JayChintala/Multirotor-Operated-Lab-Experiments-MOLE/README.md

# Multirotor-Operated-Lab-Experiments-MOLE-
Project for CMU's Electromechanical Systems Class. Aims to design a modular drone with hot swappable payloads.

This repo will contain most of the softwares, schematics for the project. 

## Companion computer (Raspberry Pi)

The Raspberry Pi companion computer setup (MAVLink routing to the flight controller, link check and bench motor test scripts) is in [`companion/`](companion/README.md).
