JayChintala/Multirotor-Operated-Lab-Experiments-MOLE/sim/README.md

# MOLE quad simulation: ArduPilot SITL + Gazebo Harmonic

Simulates the MOLE quadcopter with the **same firmware as the real flight controller**
(ArduCopter 4.7.2, `fb773567`) and the **real FC's flight parameters**, in Gazebo Harmonic
on ROS 2 Jazzy (Ubuntu 24.04).

```
Gazebo (mole_quad model, 1 kHz physics) ──JSON :9002──> ArduCopter SITL 4.7.2
                                                          ├─ tcp:5760  MAVROS (ROS 2 topics under /mavros)
                                                          └─ tcp:5762  QGroundControl, MAVProxy or scripts
```

## One-time setup (outside the repo)

SITL and the ArduPilot Gazebo plugin are built in `~/mole_sim` (the launch file's default paths):

```bash
mkdir -p ~/mole_sim && cd ~/mole_sim
# ArduCopter SITL at the exact release the real FC runs
git clone --recurse-submodules -b Copter-4.7.2 https://github.com/ArduPilot/ardupilot.git ardupilot-4.7.2
cd ardupilot-4.7.2 && Tools/environment_install/install-prereqs-ubuntu.sh -y   # once per machine
./waf configure --board sitl && ./waf copter
# ArduPilot plugin for Gazebo Harmonic
cd ~/mole_sim && git clone https://github.com/ArduPilot/ardupilot_gazebo
cd ardupilot_gazebo && mkdir -p build && cd build
source /opt/ros/jazzy/setup.bash && cmake .. -DCMAKE_BUILD_TYPE=RelWithDebInfo && make -j8
```

Also needed: `sudo apt install ros-jazzy-ros-gz ros-jazzy-mavros ros-jazzy-mavros-extras` and
MAVROS's GeographicLib datasets. (On the first machine these steps were done by hand; the
commands above are the equivalent from scratch and have not been re-run on a clean install.)

## Build and run

```bash
cd sim/ros2_ws
source /opt/ros/jazzy/setup.bash
colcon build --symlink-install
source install/setup.bash

ros2 launch mole_gazebo sitl.launch.py                    # Gazebo window, simulated GPS, MAVROS
ros2 launch mole_gazebo sitl.launch.py gps:=false         # like the real drone today: no GPS/compass
ros2 launch mole_gazebo sitl.launch.py headless:=true     # no window (CI, SSH)
```

| Argument | Default | Meaning |
|---|---|---|
| `gps` | `true` | `true`: simulated GPS + compass (Loiter/Guided/Auto/RTL work). `false`: matches the real drone, only Stabilize/AltHold/Acro |
| `mavros` | `true` | start MAVROS on `tcp:5760` |
| `headless` | `false` | Gazebo server only |
| `wipe` | `true` | start SITL from the parameter files every time (no stale eeprom) |
| `ardupilot_dir` | `~/mole_sim/ardupilot-4.7.2` | ArduPilot build with `build/sitl/bin/arducopter` |
| `ardupilot_gazebo_dir` | `~/mole_sim/ardupilot_gazebo` | plugin build with `build/libArduPilotPlugin.so` |

SITL logs (`.BIN`, same format as the real FC's) go to `~/mole_sim/runs/<date_time>/logs/`.
Close the Gazebo window or press Ctrl+C to stop everything.

Launching from **VS Code's terminal** works: the launch file removes the snap environment
variables that otherwise crash Gazebo's window.

Connect **QGroundControl** with a TCP link to `127.0.0.1:5762`, or MAVProxy with
`mavproxy.py --master=tcp:127.0.0.1:5762`.

## Check it works

```bash
PY=~/mole_sim/venv-ardupilot/bin/python      # any Python with pymavlink + Gazebo bindings
$PY src/mole_gazebo/scripts/smoke_test.py --rate-gain-scale 0.5
```

1. Motor test A–D: each spins the correct propeller in the correct direction.
2. AltHold take-off, roll/pitch steady in hover, altitude hold at mid-stick, hover throttle vs
   the real drone's 0.35.
3. Yaw right turns right. 4. Land and auto-disarm.

Results on 2026-11-08 (motor capped at the measured 2.0 kgf): **11/11 with
`--rate-gain-scale 0.5`** (roll/pitch rate 0.3 °/s RMS, altitude held within 3 cm, hover output
0.353). **With the real FC's gains the roll/pitch steadiness check fails** (62 °/s RMS). See below.
The no-GPS configuration (`gps:=false mavros:=false`) also passed every check with halved gains.

## Finding: the real FC's roll/pitch tune oscillates in simulation

With the real FC's rate gains (`ATC_RAT_RLL/PIT_P` 0.135, `_I` 0.135, `_D` 0.0036: the
ArduPilot defaults) the simulated drone's roll rate loop oscillates in hover (roll rate 62 °/s
RMS, pitch 15 °/s); with the gains halved it hovers steadily (0.3 °/s).

| Motor model | Real gains | Gains × 0.5 |
|---|---|---|
| **Capped at measured 2.0 kgf, lag 0.02 s (current)** | roll 62 °/s RMS; holds altitude | steady |
| Uncapped (extrapolated 3.8 kgf), lag 0.01 s | oscillates, climbs 18 m in 8 s | holds altitude; fast roll wobble (±3°, ≥10 Hz) |
| Uncapped, lag 0.02 s | oscillates, climbs 9.5 m | steady |
| Uncapped, lag 0.04 s | oscillates, climbs 15 m | steady |

The roll/pitch oscillation with the real gains appears in every variant. Flight log 00016 (the
cage-ceiling crash) shows motor outputs swinging between minimum (1150) and near maximum (1949)
while `CTUN.ThO` was 0 and the drone climbed ~9 m. The uncapped model reproduced that climb, but
it overstated thrust above 73 % throttle; with the motor capped at the measured 2.0 kgf the
simulated oscillation is milder and the drone does not climb. So the simulator supports
"the default roll/pitch gains are too high for this airframe" but does **not** currently
reproduce the climb. The fast wobble with 0.01 s lag is probably an artifact of the simulated
rotor speed loop (natural frequency ~10 Hz at that setting); settling it needs real motor
step-response data. **Simulation results are not a substitute for careful
real-world tuning**: use them to choose a safer starting point, then tune on the real drone
(start low, e.g. halved rate gains, tethered or at low height).

## How the model was built

All numbers are in [`config/vehicle.json`](ros2_ws/src/mole_gazebo/config/vehicle.json);
[`scripts/gen_model.py`](ros2_ws/src/mole_gazebo/scripts/gen_model.py) generates
`models/mole_quad/model.sdf` from it. Edit the JSON and re-run the script; don't edit the SDF.

| Quantity | Value | Source |
|---|---|---|
| Frame + arms + motors + Pi/FC/ESC/wiring | 0.700 kg | EMSD CAD mass properties |
| Battery (6S 12000 mAh), on top, 195 × 77 × 50 mm | 1.500 kg | team; re-measure (1.58 kg also quoted) |
| Props, 8 in | 4 × 13 g | team |
| **Total** | **2.252 kg**, CoG 37 mm above frame centre | |
| Inertia Ixx / Iyy / Izz | 0.0165 / 0.0150 / 0.0275 kg·m² | CAD + battery box + props |
| Motor layout | 280 mm front–back × 368 mm side–side | EMSD CAD; front = CAD −y (team) |
| Thrust, torque | T = 6.983e-6 ω², Q = 1.019e-7 ω² | `ROS/EMSD/motor_data.xlsx`, R² = 0.999 |
| Motor speed vs output | ω = 2214 (cmd + 0.048) rad/s | DC-motor fit of the same data, ±3 % thrust from hover to full |
| Maximum per motor | 2.0 kgf (19.7 N), ~16,000 rpm, 34.5 A | bench top point (DShot 1500, ~73 % output); team: ~2 kg at ~35 A is the real limit. Modelled as a motor torque cap (0.289 N·m), so outputs above ~0.73 add no thrust |
| Thrust/weight | 3.6 | 4 × 2.0 kgf / 2.25 kg |
| Hover | ~8,500 rpm, output 0.354 | matches real `MOT_THST_HOVER` 0.35 |
| Motor lag | 0.02 s | **assumed** |
| Spin, output channels | FR/RL CCW, FL/RR CW; SERVO1..4 = motors 4,1,2,3 | `companion/README.md`; FC log 00016 |

Propellers are spinning joints with Gazebo `LiftDrag` blades (as in ArduPilot's Iris model),
sized so thrust and reaction torque follow the measured curves.

## Parameters

| File | Contents |
|---|---|
| `config/mole_quad.parm` | 337 flight parameters from the real FC (tuning, filters, mixing, failsafes, EKF). **Generated**: re-run after retuning |
| `config/sitl_overrides.parm` | sim-only: level IMU (real FC is mounted roll-180), no output when disarmed, file logging, 6S battery |
| `config/sitl_gps.parm`, `sitl_nogps.parm` | the `gps:=` variants |

Load order: ArduPilot's stock `copter.parm` → `mole_quad.parm` → `sitl_overrides.parm` → GPS variant.

After a real flight with new parameters, refresh the sim from its log:

```bash
$PY src/mole_gazebo/scripts/extract_params.py path/to/new_log.bin src/mole_gazebo/config/mole_quad.parm
```

## Known limitations

- Motor lag is assumed (0.02 s); battery sag, ESC behaviour, prop wash, ground effect and
  vibration are not modelled. Body aerodynamic drag is not modelled.
- Motor speed is linear in output (ArduPilotPlugin limitation); thrust error ≤ 3 % over 0.15–0.95,
  larger near zero.
- Above ~73 % output the real motor is assumed current-limited at 2.0 kgf (torque cap); how
  the real ESC behaves there (current limiting vs more thrust at higher current) is not measured.
- Inertia comes from CAD with assumed component placement.
- The world is an open field; an indoor cage world needs the cage's dimensions.

## Notes for the hardware docs

`companion/README.md` says `SERVO1_FUNCTION`–`SERVO4_FUNCTION` are 33–36 (outputs 1–4 =
motors 1–4) and that `SERVO_BLH_RVMASK` = 9 reverses "motors 1 and 4". Log 00016 has
`SERVO1..4_FUNCTION` = 36, 33, 34, 35, so outputs 1 and 4 are motors **4 and 3**. The spin
directions were verified per motor, so the drone is fine; the README text is out of date.
