JayChintala/Multirotor-Operated-Lab-Experiments-MOLE/Misc/Sim1.png

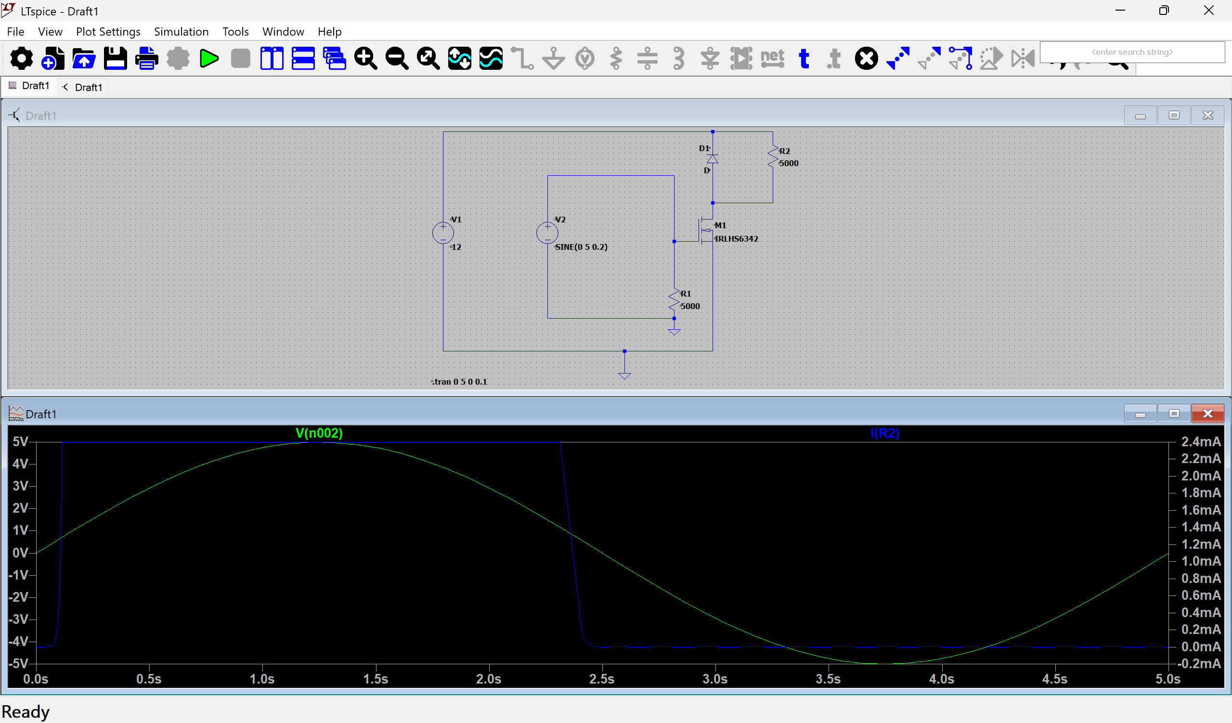
Misc/Sim1.png
