JayChintala/Multirotor-Operated-Lab-Experiments-MOLE/report/images/drone_clipart.png

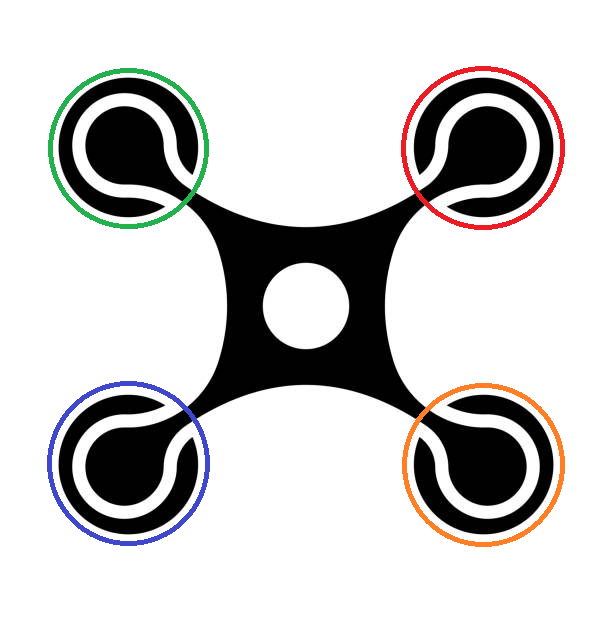
report/images/drone_clipart.png
