JayChintala/Multirotor-Operated-Lab-Experiments-MOLE/ROS/EMSD/cad/QAV-RXL2_8inch.step

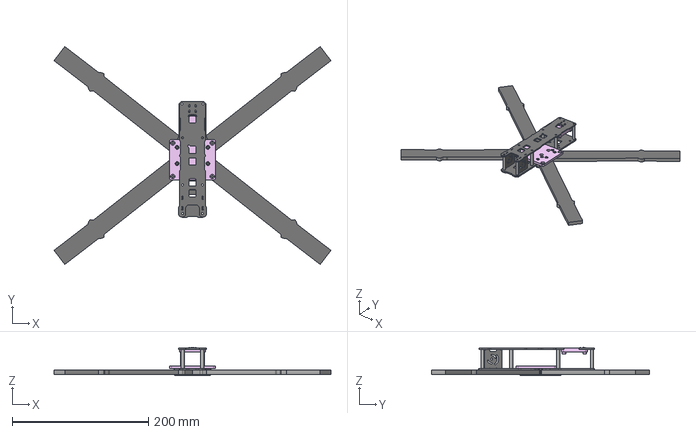
[picture p4: CAD file, 2026-11-09]
ROS/EMSD/cad/QAV-RXL2_8inch.step
406.3 x 319.7 x 41.5 mm
