JayChintala/Multirotor-Operated-Lab-Experiments-MOLE/ROS/EMSD/ros2_ws/src/emsd_drone_description/meshes/ground_pond.stl

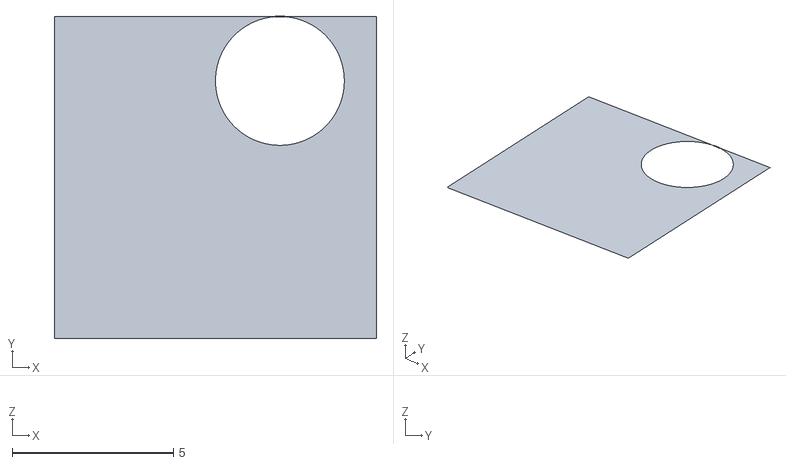
[picture p5: CAD file, 2026-11-09]
ROS/EMSD/ros2_ws/src/emsd_drone_description/meshes/ground_pond.stl
10.0 x 10.0 x 0
