JayChintala/Multirotor-Operated-Lab-Experiments-MOLE/ROS/EMSD/ros2_ws/src/emsd_drone_description/meshes/pond_bowl.stl

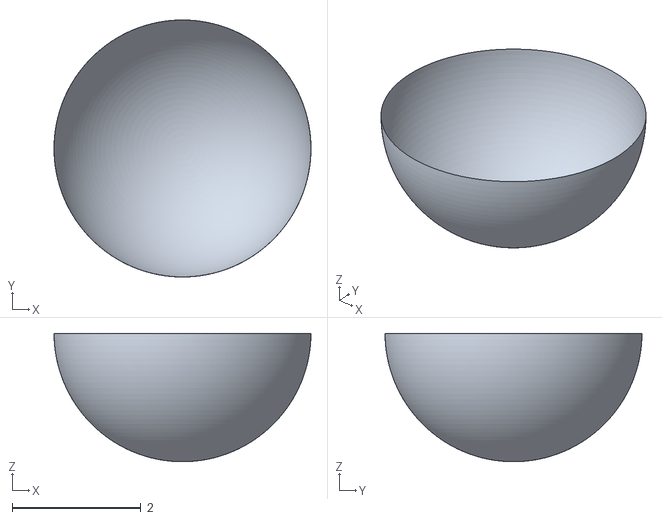
[picture p6: CAD file, 2026-11-09]
ROS/EMSD/ros2_ws/src/emsd_drone_description/meshes/pond_bowl.stl
4.00 x 4.00 x 2.00
