JayChintala/Multirotor-Operated-Lab-Experiments-MOLE/ROS/EMSD/ros2_ws/src/emsd_drone_description/meshes/frame.stl

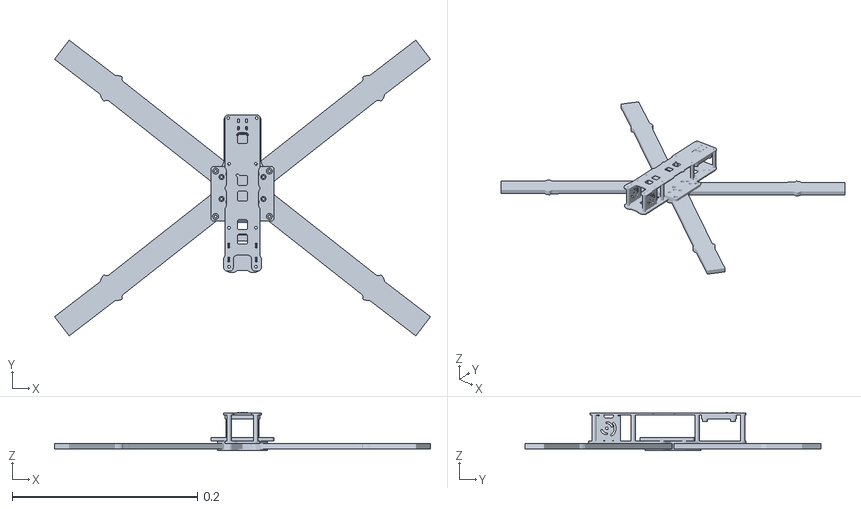
[picture p7: CAD file, 2026-11-09]
ROS/EMSD/ros2_ws/src/emsd_drone_description/meshes/frame.stl
0.406 x 0.32 x 0.0415
