JayChintala/Multirotor-Operated-Lab-Experiments-MOLE/sim/ros2_ws/src/mole_gazebo/models/mole_quad/model.sdf

<?xml version="1.0"?>
<!-- GENERATED by scripts/gen_model.py from config/vehicle.json. Do not edit by hand. -->
<!-- Total 2.252 kg; CoG [-0.0, 0.0, 37.2] mm; inertia diag [0.01647, 0.01495, 0.02751] kg m^2 -->
<sdf version="1.9">
  <model name="mole_quad">
    <link name="base_link">
      <inertial>
        <pose>-0.000008 0.000000 0.037503 0 0 0</pose>
        <mass>2.2000</mass>
        <inertia>
          <ixx>0.0147026</ixx>
          <ixy>1.2393e-09</ixy>
          <ixz>5.22634e-06</ixz>
          <iyy>0.0137637</iyy>
          <iyz>1.99803e-09</iyz>
          <izz>0.024573</izz>
        </inertia>
      </inertial>
      <collision name="frame_collision">
        <pose>0 0 0.0102 0 0 0</pose>
        <geometry><box><size>0.3197 0.4063 0.0415</size></box></geometry>
      </collision>
      <collision name="battery_collision">
        <pose>0.0 0.0 0.0560 0 0 0</pose>
        <geometry><box><size>0.195 0.077 0.05</size></box></geometry>
      </collision>
      <visual name="frame">
        <pose>0 0 0 0 0 1.570796</pose>
        <geometry><mesh><uri>model://mole_quad/meshes/frame.stl</uri></mesh></geometry>
        <material><ambient>0.24 0.3 0.38 1.0</ambient><diffuse>0.24 0.3 0.38 1.0</diffuse><specular>0.2 0.2 0.2 1</specular></material>
      </visual>
      <visual name="battery">
        <pose>0.0 0.0 0.0560 0 0 0</pose>
        <geometry><box><size>0.195 0.077 0.05</size></box></geometry>
        <material><ambient>0.85 0.75 0.1 1.0</ambient><diffuse>0.85 0.75 0.1 1.0</diffuse><specular>0.2 0.2 0.2 1</specular></material>
      </visual>
      <visual name="front_marker">
        <pose>0.1699 0 0.0310 0 0 0</pose>
        <geometry><sphere><radius>0.012</radius></sphere></geometry>
        <material><ambient>0.9 0.1 0.1 1.0</ambient><diffuse>0.9 0.1 0.1 1.0</diffuse><specular>0.2 0.2 0.2 1</specular></material>
      </visual>
      <visual name="motor_front_right">
        <pose>0.14 -0.184 0.0075 0 0 0</pose>
        <geometry><cylinder><radius>0.014</radius><length>0.020</length></cylinder></geometry>
        <material><ambient>0.08 0.08 0.08 1.0</ambient><diffuse>0.08 0.08 0.08 1.0</diffuse><specular>0.2 0.2 0.2 1</specular></material>
      </visual>
      <visual name="motor_rear_left">
        <pose>-0.14 0.184 0.0075 0 0 0</pose>
        <geometry><cylinder><radius>0.014</radius><length>0.020</length></cylinder></geometry>
        <material><ambient>0.08 0.08 0.08 1.0</ambient><diffuse>0.08 0.08 0.08 1.0</diffuse><specular>0.2 0.2 0.2 1</specular></material>
      </visual>
      <visual name="motor_front_left">
        <pose>0.14 0.184 0.0075 0 0 0</pose>
        <geometry><cylinder><radius>0.014</radius><length>0.020</length></cylinder></geometry>
        <material><ambient>0.08 0.08 0.08 1.0</ambient><diffuse>0.08 0.08 0.08 1.0</diffuse><specular>0.2 0.2 0.2 1</specular></material>
      </visual>
      <visual name="motor_rear_right">
        <pose>-0.14 -0.184 0.0075 0 0 0</pose>
        <geometry><cylinder><radius>0.014</radius><length>0.020</length></cylinder></geometry>
        <material><ambient>0.08 0.08 0.08 1.0</ambient><diffuse>0.08 0.08 0.08 1.0</diffuse><specular>0.2 0.2 0.2 1</specular></material>
      </visual>
      <sensor name="imu_sensor" type="imu">
        <pose degrees="true">0 0 0 180 0 0</pose>
        <always_on>1</always_on>
        <update_rate>1000</update_rate>
      </sensor>
    </link>

    <link name="rotor_front_right">
      <pose>0.14 -0.184 0.0225 0 0 0</pose>
      <inertial>
        <mass>0.013</mass>
        <inertia>
          <ixx>1e-07</ixx>
          <ixy>0</ixy>
          <ixz>0</ixz>
          <iyy>4e-05</iyy>
          <iyz>0</iyz>
          <izz>4e-05</izz>
        </inertia>
      </inertial>
      <visual name="blades">
        <geometry><box><size>0.2032 0.018 0.003</size></box></geometry>
        <material><ambient>0.15 0.4 0.95 1.0</ambient><diffuse>0.15 0.4 0.95 1.0</diffuse><specular>0.2 0.2 0.2 1</specular></material>
      </visual>
      <visual name="disc">
        <geometry><cylinder><radius>0.1016</radius><length>0.001</length></cylinder></geometry>
        <transparency>0.75</transparency>
        <material><ambient>0.15 0.4 0.95 0.25</ambient><diffuse>0.15 0.4 0.95 0.25</diffuse><specular>0.2 0.2 0.2 1</specular></material>
      </visual>
    </link>
    <joint name="rotor_front_right_joint" type="revolute">
      <parent>base_link</parent>
      <child>rotor_front_right</child>
      <axis>
        <xyz>0 0 1</xyz>
        <limit><lower>-1e16</lower><upper>1e16</upper></limit>
        <dynamics><damping>1e-6</damping></dynamics>
      </axis>
    </joint>
    <link name="rotor_rear_left">
      <pose>-0.14 0.184 0.0225 0 0 0</pose>
      <inertial>
        <mass>0.013</mass>
        <inertia>
          <ixx>1e-07</ixx>
          <ixy>0</ixy>
          <ixz>0</ixz>
          <iyy>4e-05</iyy>
          <iyz>0</iyz>
          <izz>4e-05</izz>
        </inertia>
      </inertial>
      <visual name="blades">
        <geometry><box><size>0.2032 0.018 0.003</size></box></geometry>
        <material><ambient>0.15 0.4 0.95 1.0</ambient><diffuse>0.15 0.4 0.95 1.0</diffuse><specular>0.2 0.2 0.2 1</specular></material>
      </visual>
      <visual name="disc">
        <geometry><cylinder><radius>0.1016</radius><length>0.001</length></cylinder></geometry>
        <transparency>0.75</transparency>
        <material><ambient>0.15 0.4 0.95 0.25</ambient><diffuse>0.15 0.4 0.95 0.25</diffuse><specular>0.2 0.2 0.2 1</specular></material>
      </visual>
    </link>
    <joint name="rotor_rear_left_joint" type="revolute">
      <parent>base_link</parent>
      <child>rotor_rear_left</child>
      <axis>
        <xyz>0 0 1</xyz>
        <limit><lower>-1e16</lower><upper>1e16</upper></limit>
        <dynamics><damping>1e-6</damping></dynamics>
      </axis>
    </joint>
    <link name="rotor_front_left">
      <pose>0.14 0.184 0.0225 0 0 0</pose>
      <inertial>
        <mass>0.013</mass>
        <inertia>
          <ixx>1e-07</ixx>
          <ixy>0</ixy>
          <ixz>0</ixz>
          <iyy>4e-05</iyy>
          <iyz>0</iyz>
          <izz>4e-05</izz>
        </inertia>
      </inertial>
      <visual name="blades">
        <geometry><box><size>0.2032 0.018 0.003</size></box></geometry>
        <material><ambient>1.0 0.5 0.1 1.0</ambient><diffuse>1.0 0.5 0.1 1.0</diffuse><specular>0.2 0.2 0.2 1</specular></material>
      </visual>
      <visual name="disc">
        <geometry><cylinder><radius>0.1016</radius><length>0.001</length></cylinder></geometry>
        <transparency>0.75</transparency>
        <material><ambient>1.0 0.5 0.1 0.25</ambient><diffuse>1.0 0.5 0.1 0.25</diffuse><specular>0.2 0.2 0.2 1</specular></material>
      </visual>
    </link>
    <joint name="rotor_front_left_joint" type="revolute">
      <parent>base_link</parent>
      <child>rotor_front_left</child>
      <axis>
        <xyz>0 0 1</xyz>
        <limit><lower>-1e16</lower><upper>1e16</upper></limit>
        <dynamics><damping>1e-6</damping></dynamics>
      </axis>
    </joint>
    <link name="rotor_rear_right">
      <pose>-0.14 -0.184 0.0225 0 0 0</pose>
      <inertial>
        <mass>0.013</mass>
        <inertia>
          <ixx>1e-07</ixx>
          <ixy>0</ixy>
          <ixz>0</ixz>
          <iyy>4e-05</iyy>
          <iyz>0</iyz>
          <izz>4e-05</izz>
        </inertia>
      </inertial>
      <visual name="blades">
        <geometry><box><size>0.2032 0.018 0.003</size></box></geometry>
        <material><ambient>1.0 0.5 0.1 1.0</ambient><diffuse>1.0 0.5 0.1 1.0</diffuse><specular>0.2 0.2 0.2 1</specular></material>
      </visual>
      <visual name="disc">
        <geometry><cylinder><radius>0.1016</radius><length>0.001</length></cylinder></geometry>
        <transparency>0.75</transparency>
        <material><ambient>1.0 0.5 0.1 0.25</ambient><diffuse>1.0 0.5 0.1 0.25</diffuse><specular>0.2 0.2 0.2 1</specular></material>
      </visual>
    </link>
    <joint name="rotor_rear_right_joint" type="revolute">
      <parent>base_link</parent>
      <child>rotor_rear_right</child>
      <axis>
        <xyz>0 0 1</xyz>
        <limit><lower>-1e16</lower><upper>1e16</upper></limit>
        <dynamics><damping>1e-6</damping></dynamics>
      </axis>
    </joint>

    <plugin filename="gz-sim-lift-drag-system" name="gz::sim::systems::LiftDrag">
      <link_name>rotor_front_right</link_name>
      <cp>0.07112 0 0</cp>
      <forward>0 1 0</forward>
      <upward>0 0 1</upward>
      <a0>0.3</a0>
      <cla>4.25</cla>
      <cda>0.87203</cda>
      <cma>0</cma>
      <alpha_stall>1.4</alpha_stall>
      <cla_stall>-0.025</cla_stall>
      <cda_stall>0</cda_stall>
      <cma_stall>0</cma_stall>
      <area>0.000899261</area>
      <air_density>1.2041</air_density>
    </plugin>
    <plugin filename="gz-sim-lift-drag-system" name="gz::sim::systems::LiftDrag">
      <link_name>rotor_front_right</link_name>
      <cp>-0.07112 0 0</cp>
      <forward>0 -1 0</forward>
      <upward>0 0 1</upward>
      <a0>0.3</a0>
      <cla>4.25</cla>
      <cda>0.87203</cda>
      <cma>0</cma>
      <alpha_stall>1.4</alpha_stall>
      <cla_stall>-0.025</cla_stall>
      <cda_stall>0</cda_stall>
      <cma_stall>0</cma_stall>
      <area>0.000899261</area>
      <air_density>1.2041</air_density>
    </plugin>
    <plugin filename="gz-sim-lift-drag-system" name="gz::sim::systems::LiftDrag">
      <link_name>rotor_rear_left</link_name>
      <cp>0.07112 0 0</cp>
      <forward>0 1 0</forward>
      <upward>0 0 1</upward>
      <a0>0.3</a0>
      <cla>4.25</cla>
      <cda>0.87203</cda>
      <cma>0</cma>
      <alpha_stall>1.4</alpha_stall>
      <cla_stall>-0.025</cla_stall>
      <cda_stall>0</cda_stall>
      <cma_stall>0</cma_stall>
      <area>0.000899261</area>
      <air_density>1.2041</air_density>
    </plugin>
    <plugin filename="gz-sim-lift-drag-system" name="gz::sim::systems::LiftDrag">
      <link_name>rotor_rear_left</link_name>
      <cp>-0.07112 0 0</cp>
      <forward>0 -1 0</forward>
      <upward>0 0 1</upward>
      <a0>0.3</a0>
      <cla>4.25</cla>
      <cda>0.87203</cda>
      <cma>0</cma>
      <alpha_stall>1.4</alpha_stall>
      <cla_stall>-0.025</cla_stall>
      <cda_stall>0</cda_stall>
      <cma_stall>0</cma_stall>
      <area>0.000899261</area>
      <air_density>1.2041</air_density>
    </plugin>
    <plugin filename="gz-sim-lift-drag-system" name="gz::sim::systems::LiftDrag">
      <link_name>rotor_front_left</link_name>
      <cp>0.07112 0 0</cp>
      <forward>0 -1 0</forward>
      <upward>0 0 1</upward>
      <a0>0.3</a0>
      <cla>4.25</cla>
      <cda>0.87203</cda>
      <cma>0</cma>
      <alpha_stall>1.4</alpha_stall>
      <cla_stall>-0.025</cla_stall>
      <cda_stall>0</cda_stall>
      <cma_stall>0</cma_stall>
      <area>0.000899261</area>
      <air_density>1.2041</air_density>
    </plugin>
    <plugin filename="gz-sim-lift-drag-system" name="gz::sim::systems::LiftDrag">
      <link_name>rotor_front_left</link_name>
      <cp>-0.07112 0 0</cp>
      <forward>0 1 0</forward>
      <upward>0 0 1</upward>
      <a0>0.3</a0>
      <cla>4.25</cla>
      <cda>0.87203</cda>
      <cma>0</cma>
      <alpha_stall>1.4</alpha_stall>
      <cla_stall>-0.025</cla_stall>
      <cda_stall>0</cda_stall>
      <cma_stall>0</cma_stall>
      <area>0.000899261</area>
      <air_density>1.2041</air_density>
    </plugin>
    <plugin filename="gz-sim-lift-drag-system" name="gz::sim::systems::LiftDrag">
      <link_name>rotor_rear_right</link_name>
      <cp>0.07112 0 0</cp>
      <forward>0 -1 0</forward>
      <upward>0 0 1</upward>
      <a0>0.3</a0>
      <cla>4.25</cla>
      <cda>0.87203</cda>
      <cma>0</cma>
      <alpha_stall>1.4</alpha_stall>
      <cla_stall>-0.025</cla_stall>
      <cda_stall>0</cda_stall>
      <cma_stall>0</cma_stall>
      <area>0.000899261</area>
      <air_density>1.2041</air_density>
    </plugin>
    <plugin filename="gz-sim-lift-drag-system" name="gz::sim::systems::LiftDrag">
      <link_name>rotor_rear_right</link_name>
      <cp>-0.07112 0 0</cp>
      <forward>0 1 0</forward>
      <upward>0 0 1</upward>
      <a0>0.3</a0>
      <cla>4.25</cla>
      <cda>0.87203</cda>
      <cma>0</cma>
      <alpha_stall>1.4</alpha_stall>
      <cla_stall>-0.025</cla_stall>
      <cda_stall>0</cda_stall>
      <cma_stall>0</cma_stall>
      <area>0.000899261</area>
      <air_density>1.2041</air_density>
    </plugin>

    <plugin filename="gz-sim-joint-state-publisher-system" name="gz::sim::systems::JointStatePublisher"/>

    <plugin name="ArduPilotPlugin" filename="ArduPilotPlugin">
      <fdm_addr>127.0.0.1</fdm_addr>
      <fdm_port_in>9002</fdm_port_in>
      <connectionTimeoutMaxCount>5</connectionTimeoutMaxCount>
      <lock_step>1</lock_step>
      <have_32_channels>0</have_32_channels>
      <modelXYZToAirplaneXForwardZDown degrees="true">0 0 0 180 0 0</modelXYZToAirplaneXForwardZDown>
      <gazeboXYZToNED degrees="true">0 0 0 180 0 90</gazeboXYZToNED>
      <imuName>base_link::imu_sensor</imuName>

      <!-- SERVO2 = ArduPilot motor 1 (front-right, CCW) -->
      <control channel="1">
        <jointName>rotor_front_right_joint</jointName>
        <useForce>1</useForce>
        <type>VELOCITY</type>
        <multiplier>2213.8</multiplier>
        <offset>0.0481</offset>
        <servo_min>1000</servo_min>
        <servo_max>2000</servo_max>
        <p_gain>0.002</p_gain>
        <i_gain>0.0390625</i_gain>
        <d_gain>0</d_gain>
        <i_max>0.289</i_max>
        <i_min>-0.289</i_min>
        <cmd_max>0.289</cmd_max>
        <cmd_min>-0.289</cmd_min>
        <controlVelocitySlowdownSim>1</controlVelocitySlowdownSim>
      </control>
      <!-- SERVO3 = ArduPilot motor 2 (rear-left, CCW) -->
      <control channel="2">
        <jointName>rotor_rear_left_joint</jointName>
        <useForce>1</useForce>
        <type>VELOCITY</type>
        <multiplier>2213.8</multiplier>
        <offset>0.0481</offset>
        <servo_min>1000</servo_min>
        <servo_max>2000</servo_max>
        <p_gain>0.002</p_gain>
        <i_gain>0.0390625</i_gain>
        <d_gain>0</d_gain>
        <i_max>0.289</i_max>
        <i_min>-0.289</i_min>
        <cmd_max>0.289</cmd_max>
        <cmd_min>-0.289</cmd_min>
        <controlVelocitySlowdownSim>1</controlVelocitySlowdownSim>
      </control>
      <!-- SERVO4 = ArduPilot motor 3 (front-left, CW) -->
      <control channel="3">
        <jointName>rotor_front_left_joint</jointName>
        <useForce>1</useForce>
        <type>VELOCITY</type>
        <multiplier>-2213.8</multiplier>
        <offset>0.0481</offset>
        <servo_min>1000</servo_min>
        <servo_max>2000</servo_max>
        <p_gain>0.002</p_gain>
        <i_gain>0.0390625</i_gain>
        <d_gain>0</d_gain>
        <i_max>0.289</i_max>
        <i_min>-0.289</i_min>
        <cmd_max>0.289</cmd_max>
        <cmd_min>-0.289</cmd_min>
        <controlVelocitySlowdownSim>1</controlVelocitySlowdownSim>
      </control>
      <!-- SERVO1 = ArduPilot motor 4 (rear-right, CW) -->
      <control channel="0">
        <jointName>rotor_rear_right_joint</jointName>
        <useForce>1</useForce>
        <type>VELOCITY</type>
        <multiplier>-2213.8</multiplier>
        <offset>0.0481</offset>
        <servo_min>1000</servo_min>
        <servo_max>2000</servo_max>
        <p_gain>0.002</p_gain>
        <i_gain>0.0390625</i_gain>
        <d_gain>0</d_gain>
        <i_max>0.289</i_max>
        <i_min>-0.289</i_min>
        <cmd_max>0.289</cmd_max>
        <cmd_min>-0.289</cmd_min>
        <controlVelocitySlowdownSim>1</controlVelocitySlowdownSim>
      </control>
    </plugin>
  </model>
</sdf>
