JayChintala/Multirotor-Operated-Lab-Experiments-MOLE/sim/ros2_ws/src/mole_gazebo/config/mole_quad.parm

# MOLE quad: flight parameters from the real flight controller.
# Source log: flight_logs/00016-2026-10-26_22-20-44.bin (branch flight-testing)
# Firmware:   ArduCopter V4.7.2 (fb773567)
# Generated:  2026-11-08 by extract_params.py (337 of 1260 parameters kept)
# Do not edit by hand: re-run extract_params.py after retuning the real drone.
ACRO_BAL_PITCH       1
ACRO_BAL_ROLL        1
ACRO_OPTIONS         0
ACRO_RP_EXPO         0.3
ACRO_RP_RATE         360
ACRO_RP_RATE_TC      0
ACRO_THR_MID         0
ACRO_TRAINER         2
ACRO_Y_EXPO          0
ACRO_Y_RATE          202.5
ACRO_Y_RATE_TC       0
AHRS_EKF_TYPE        3
AHRS_GPS_GAIN        1
AHRS_GPS_MINSATS     6
AHRS_GPS_USE         1
ARMING_ACCTHRESH     0.75
ARMING_NEED_LOC      0
ARMING_OPTIONS       0
ARMING_RUDDER        2
ARMING_SKIPCHK       5196
ATC_ACC_P_MAX        1100
ATC_ACC_R_MAX        1100
ATC_ACC_Y_MAX        270
ATC_ANGLE_BOOST      1
ATC_ANGLE_MAX        30
ATC_ANG_LIM_TC       1
ATC_ANG_PIT_P        4.5
ATC_ANG_RLL_P        4.5
ATC_ANG_YAW_P        4.5
ATC_INPUT_TC         0.1
ATC_LAND_P_MULT      1
ATC_LAND_R_MULT      1
ATC_LAND_Y_MULT      1
ATC_RATE_FF_ENAB     1
ATC_RATE_P_MAX       0
ATC_RATE_R_MAX       0
ATC_RATE_WPY_MAX     60
ATC_RATE_Y_MAX       0
ATC_RAT_PIT_D        0.0036
ATC_RAT_PIT_D_FF     0
ATC_RAT_PIT_FF       0
ATC_RAT_PIT_FLTD     20
ATC_RAT_PIT_FLTE     0
ATC_RAT_PIT_FLTT     20
ATC_RAT_PIT_I        0.135
ATC_RAT_PIT_IMAX     0.5
ATC_RAT_PIT_NEF      0
ATC_RAT_PIT_NTF      0
ATC_RAT_PIT_P        0.135
ATC_RAT_PIT_PDMX     0
ATC_RAT_PIT_SMAX     0
ATC_RAT_RLL_D        0.0036
ATC_RAT_RLL_D_FF     0
ATC_RAT_RLL_FF       0
ATC_RAT_RLL_FLTD     20
ATC_RAT_RLL_FLTE     0
ATC_RAT_RLL_FLTT     20
ATC_RAT_RLL_I        0.135
ATC_RAT_RLL_IMAX     0.5
ATC_RAT_RLL_NEF      0
ATC_RAT_RLL_NTF      0
ATC_RAT_RLL_P        0.135
ATC_RAT_RLL_PDMX     0
ATC_RAT_RLL_SMAX     0
ATC_RAT_YAW_D        0
ATC_RAT_YAW_D_FF     0
ATC_RAT_YAW_FF       0
ATC_RAT_YAW_FLTD     20
ATC_RAT_YAW_FLTE     2.5
ATC_RAT_YAW_FLTT     20
ATC_RAT_YAW_I        0.018
ATC_RAT_YAW_IMAX     0.5
ATC_RAT_YAW_NEF      0
ATC_RAT_YAW_NTF      0
ATC_RAT_YAW_P        0.18
ATC_RAT_YAW_PDMX     0
ATC_RAT_YAW_SMAX     0
ATC_THR_G_BOOST      0
ATC_THR_MIX_MAN      0.1
ATC_THR_MIX_MAX      0.5
ATC_THR_MIX_MIN      0.1
AUTOTUNE_AGGR        0.075
AUTOTUNE_AXES        7
AUTOTUNE_GMBK        0.25
AUTOTUNE_MIN_D       0.0005
AVOID_ACCEL_MAX      3
AVOID_ALT_MIN        0
AVOID_BACKUP_DZ      0.1
AVOID_BACKUP_SPD     0.75
AVOID_BACKZ_SPD      0.75
AVOID_BEHAVE         0
AVOID_DIST_MAX       5
AVOID_ENABLE         3
AVOID_MARGIN         2
BATT_ARM_MAH         0
BATT_ARM_VOLT        22
BATT_CAPACITY        12000
BATT_CRT_MAH         0
BATT_CRT_VOLT        19.8
BATT_FS_CRT_ACT      1
BATT_FS_LOW_ACT      1
BATT_FS_VOLTSRC      0
BATT_LOW_MAH         0
BATT_LOW_TIMER       10
BATT_LOW_VOLT        21
COMPASS_ENABLE       0
DISARM_DELAY         10
EK3_ABIAS_P_NSE      0.02
EK3_ACC_BIAS_LIM     1
EK3_ACC_P_NSE        0.35
EK3_AFFINITY         0
EK3_ALT_M_NSE        2
EK3_BCN_DELAY        50
EK3_BCN_I_GTE        500
EK3_BCN_M_NSE        1
EK3_BETA_MASK        0
EK3_DRAG_BCOEF_X     0
EK3_DRAG_BCOEF_Y     0
EK3_DRAG_MCOEF       0
EK3_DRAG_M_NSE       0.5
EK3_EAS_I_GATE       400
EK3_EAS_M_NSE        1.4
EK3_ENABLE           1
EK3_ERR_THRESH       0.2
EK3_FLOW_DELAY       10
EK3_FLOW_I_GATE      300
EK3_FLOW_MAX         2.5
EK3_FLOW_M_NSE       0.25
EK3_FLOW_USE         1
EK3_GBIAS_P_NSE      0.001
EK3_GLITCH_RAD       25
EK3_GND_EFF_DZ       4
EK3_GPS_CHECK        31
EK3_GPS_VACC_MAX     0
EK3_GSF_RST_MAX      2
EK3_GSF_RUN_MASK     3
EK3_GSF_USE_MASK     3
EK3_GYRO_P_NSE       0.015
EK3_HGT_DELAY        60
EK3_HGT_I_GATE       500
EK3_HRT_FILT         2
EK3_IMU_MASK         3
EK3_LOG_LEVEL        0
EK3_MAGB_P_NSE       0.0001
EK3_MAGE_P_NSE       0.001
EK3_MAG_CAL          3
EK3_MAG_EF_LIM       50
EK3_MAG_I_GATE       300
EK3_MAG_MASK         0
EK3_MAG_M_NSE        0.05
EK3_NOAID_M_NSE      10
EK3_OGNM_TEST_SF     2
EK3_OGN_HGT_MASK     0
EK3_OPTIONS          0
EK3_POSNE_M_NSE      0.5
EK3_POS_I_GATE       500
EK3_PRIMARY          0
EK3_RNG_I_GATE       500
EK3_RNG_M_NSE        0.5
EK3_RNG_USE_HGT      -1
EK3_RNG_USE_SPD      2
EK3_SRC1_POSXY       3
EK3_SRC1_POSZ        1
EK3_SRC1_VELXY       3
EK3_SRC1_VELZ        3
EK3_SRC1_YAW         1
EK3_SRC2_POSXY       0
EK3_SRC2_POSZ        1
EK3_SRC2_VELXY       0
EK3_SRC2_VELZ        0
EK3_SRC2_YAW         0
EK3_SRC3_POSXY       0
EK3_SRC3_POSZ        1
EK3_SRC3_VELXY       0
EK3_SRC3_VELZ        0
EK3_SRC3_YAW         0
EK3_SRC_OPTIONS      0
EK3_TAU_OUTPUT       25
EK3_TERR_GRAD        0.1
EK3_VELD_M_NSE       0.5
EK3_VELNE_M_NSE      0.3
EK3_VEL_I_GATE       500
EK3_VIS_VERR_MAX     0.9
EK3_VIS_VERR_MIN     0.1
EK3_WENC_VERR        0.1
EK3_WIND_PSCALE      1
EK3_WIND_P_NSE       0.2
EK3_YAW_I_GATE       300
EK3_YAW_M_NSE        0.5
FENCE_ACTION         1
FENCE_ALT_MAX        100
FENCE_ALT_MAX_TP     1
FENCE_ALT_MIN        -10
FENCE_ALT_MIN_TP     1
FENCE_AUTOENABLE     0
FENCE_ENABLE         0
FENCE_MARGIN         2
FENCE_MARGIN_XY      0
FENCE_NTF_FREQ       1
FENCE_OPTIONS        0
FENCE_RADIUS         300
FENCE_TOTAL          0
FENCE_TYPE           7
FLTMODE1             0
FLTMODE2             0
FLTMODE3             0
FLTMODE4             0
FLTMODE5             0
FLTMODE6             0
FLTMODE_CH           5
FLTMODE_GCSBLOCK     0
FRAME_CLASS          1
FRAME_TYPE           1
FS_CRASH_CHECK       1
FS_DR_ENABLE         2
FS_DR_TIMEOUT        30
FS_EKF_ACTION        1
FS_EKF_FILT          5
FS_EKF_THRESH        0.8
FS_GCS_ENABLE        5
FS_GCS_TIMEOUT       5
FS_OPTIONS           0
FS_THR_ENABLE        0
FS_THR_VALUE         975
FS_VIBE_ENABLE       1
GPS1_TYPE            1
INS_ACCEL_FILTER     20
INS_GYRO_FILTER      20
INS_HNTC2_ENABLE     0
INS_HNTCH_ENABLE     0
LAND_ALT_LOW_M       10
LAND_REPOSITION      1
LAND_SPD_HIGH_MS     0
LAND_SPD_MS          0.5
LOIT_ACC_MAX_M       5
LOIT_ANG_MAX         0
LOIT_BRK_ACC_M       2.5
LOIT_BRK_DELAY       1
LOIT_BRK_JRK_M       5
LOIT_OPTIONS         1
LOIT_SPEED_MS        12.5
MOT_BAT_CURR_MAX     0
MOT_BAT_CURR_TC      5
MOT_BAT_IDX          0
MOT_BAT_VOLT_MAX     25.2
MOT_BAT_VOLT_MIN     19.8
MOT_HOVER_LEARN      2
MOT_IDLE_SEC         0
MOT_OPTIONS          0
MOT_PWM_MAX          2000
MOT_PWM_MIN          1000
MOT_SAFE_TIME        1
MOT_SLEW_DN_TIME     0
MOT_SLEW_UP_TIME     0
MOT_SPIN_ARM         0.1
MOT_SPIN_MAX         0.95
MOT_SPIN_MIN         0.15
MOT_SPOOL_TIME       0.5
MOT_SPOOL_TIM_DN     0
MOT_THST_EXPO        0.65
MOT_THST_HOVER       0.3498991
MOT_YAW_HEADROOM     200
PILOT_ACC_Z          2.5
PILOT_SPD_DN         0
PILOT_SPD_UP         2.5
PILOT_THR_BHV        0
PILOT_THR_FILT       0
PILOT_TKO_ALT_M      0
PILOT_Y_EXPO         0
PILOT_Y_RATE         202.5
PILOT_Y_RATE_TC      0
PSC_ANGLE_MAX        0
PSC_D_ACC_D          0
PSC_D_ACC_D_FF       0
PSC_D_ACC_FF         0
PSC_D_ACC_FLTD       0
PSC_D_ACC_FLTE       20
PSC_D_ACC_FLTT       0
PSC_D_ACC_I          0.1
PSC_D_ACC_IMAX       0.8
PSC_D_ACC_NEF        0
PSC_D_ACC_NTF        0
PSC_D_ACC_P          0.05
PSC_D_ACC_PDMX       0
PSC_D_ACC_SMAX       0
PSC_D_JERK           5
PSC_D_POS_P          1
PSC_D_VEL_D          0
PSC_D_VEL_FF         0
PSC_D_VEL_FLTD       5
PSC_D_VEL_FLTE       5
PSC_D_VEL_I          0
PSC_D_VEL_IMAX       10
PSC_D_VEL_P          5
PSC_NE_JERK          5
PSC_NE_POS_P         1
PSC_NE_VEL_D         0.25
PSC_NE_VEL_FF        0
PSC_NE_VEL_FLTD      5
PSC_NE_VEL_FLTE      5
PSC_NE_VEL_I         1
PSC_NE_VEL_IMAX      10
PSC_NE_VEL_P         2
RCMAP_PITCH          2
RCMAP_ROLL           1
RCMAP_THROTTLE       3
RCMAP_YAW            4
RTL_ALT_FINAL_M      0
RTL_ALT_M            15
RTL_ALT_TYPE         0
RTL_CLIMB_MIN_M      0
RTL_CONE_SLOPE       3
RTL_LOIT_TIME        5000
RTL_OPTIONS          0
RTL_SPEED_MS         0
SCHED_LOOP_RATE      400
SERVO1_FUNCTION      36
SERVO2_FUNCTION      33
SERVO3_FUNCTION      34
SERVO4_FUNCTION      35
THR_DZ               100
TKOFF_RPM_MAX        0
TKOFF_RPM_MIN        0
TKOFF_SLEW_TIME      2
TKOFF_THR_MAX        0.9
WP_ACC               2.5
WP_ACC_CNR           0
WP_ACC_Z             1
WP_JERK              1
WP_NAVALT_MIN        0
WP_RADIUS_M          2
WP_RFND_USE          1
WP_SPD               10
WP_SPD_DN            1.5
WP_SPD_UP            2.5
WP_TER_MARGIN        10
WP_YAW_BEHAVIOR      2
