JayChintala/Multirotor-Operated-Lab-Experiments-MOLE/sim/ros2_ws/src/mole_gazebo/scripts/smoke_test.py

#!/usr/bin/env python3
"""Check the MOLE SITL model end to end. Run while sitl.launch.py is up:

    PY=~/mole_sim/venv-ardupilot/bin/python
    $PY smoke_test.py                          # all checks with the real FC's tune
    $PY smoke_test.py --rate-gain-scale 0.5    # same, roll/pitch rate gains halved for this run
    $PY smoke_test.py --motors                 # motor order/spin only

1. Motor test (disarmed): ArduPilot's motor test A-D must spin the right
   propeller in the right direction (ArduPilot Quad X; companion/README.md).
2. AltHold flight via RC override (how the real drone is flown, no GPS needed):
   climb, roll/pitch steady, hold altitude at mid-stick, hover throttle vs the real 0.35.
3. Yaw right: heading must increase. 4. Land and auto-disarm.
Exit code 0 when every check passes.

With the real FC's roll/pitch gains (log 00016) the steadiness check FAILS:
the roll/pitch rate loops oscillate (about 60 deg/s RMS).
See sim/README.md. --rate-gain-scale changes the gains only for this run.
"""
import argparse
import math
import sys
import threading
import time

from pymavlink import mavutil

# Motor test order A-D is clockwise from front-right; expected rotor and spin (+ = CCW from above).
MOTOR_TEST = [('A', 'rotor_front_right', +1), ('B', 'rotor_rear_right', -1),
              ('C', 'rotor_rear_left', +1), ('D', 'rotor_front_left', -1)]
EXPECTED_HOVER = 0.35            # real FC MOT_THST_HOVER and the motor-data prediction
WORLD, MODEL = 'mole_field', 'mole_quad'

results = []


def check(name, ok, detail=''):
    results.append(ok)
    print(f'  [{"PASS" if ok else "FAIL"}] {name}' + (f': {detail}' if detail else ''), flush=True)


class Joints:
    """Latest rotor joint velocities from Gazebo's JointStatePublisher."""

    def __init__(self):
        from gz.msgs10.model_pb2 import Model
        from gz.transport13 import Node
        self.vel, self.node = {}, Node()
        topic = f'/world/{WORLD}/model/{MODEL}/joint_state'
        if not self.node.subscribe(Model, topic, self._cb):
            raise RuntimeError(f'cannot subscribe to {topic}')

    def _cb(self, msg):
        for j in msg.joint:
            self.vel[j.name.replace('_joint', '')] = j.axis1.velocity


class Vehicle:
    def __init__(self, url):
        self.m = mavutil.mavlink_connection(url, source_system=255)
        # Lock onto the autopilot itself: MAVROS's heartbeat is forwarded on this link too.
        end = time.time() + 60
        while time.time() < end:
            hb = self.m.recv_match(type='HEARTBEAT', blocking=True, timeout=5)
            if hb and hb.get_srcComponent() == mavutil.mavlink.MAV_COMP_ID_AUTOPILOT1:
                self.m.target_system, self.m.target_component = hb.get_srcSystem(), hb.get_srcComponent()
                break
        else:
            raise RuntimeError(f'no autopilot heartbeat on {url}')
        self.rc = [0] * 8
        self.state = {}
        # This link gets no telemetry until asked: request what the checks read, at 10 Hz.
        for msg_id in (mavutil.mavlink.MAVLINK_MSG_ID_SERVO_OUTPUT_RAW, mavutil.mavlink.MAVLINK_MSG_ID_VFR_HUD,
                       mavutil.mavlink.MAVLINK_MSG_ID_GLOBAL_POSITION_INT, mavutil.mavlink.MAVLINK_MSG_ID_ATTITUDE):
            self.command(mavutil.mavlink.MAV_CMD_SET_MESSAGE_INTERVAL, msg_id, 100_000)
        threading.Thread(target=self._loop, daemon=True).start()

    def _loop(self):
        """Heartbeat (FS_GCS_ENABLE is on), RC override at 10 Hz, and message capture."""
        last_hb = 0
        while True:
            now = time.time()
            if now - last_hb > 0.5:
                self.m.mav.heartbeat_send(mavutil.mavlink.MAV_TYPE_GCS, mavutil.mavlink.MAV_AUTOPILOT_INVALID, 0, 0, 0)
                last_hb = now
            if any(self.rc):
                self.m.mav.rc_channels_override_send(self.m.target_system, self.m.target_component, *self.rc)
            while (msg := self.m.recv_match(blocking=False)) is not None:
                t = msg.get_type()
                if t == 'HEARTBEAT' and (msg.get_srcSystem(), msg.get_srcComponent()) != (
                        self.m.target_system, self.m.target_component):
                    continue              # e.g. MAVROS's own heartbeat, forwarded by the FC
                self.state[t] = msg
                if t == 'STATUSTEXT':
                    print(f'      FC: {msg.text}', flush=True)
            time.sleep(0.1)

    def get(self, t, timeout=5):
        end = time.time() + timeout
        while time.time() < end:
            if t in self.state:
                return self.state[t]
            time.sleep(0.05)
        return None

    def command(self, cmd, *params):
        self.m.mav.command_long_send(self.m.target_system, self.m.target_component, cmd, 0,
                                     *(list(params) + [0] * (7 - len(params))))

    def wait(self, predicate, timeout):
        end = time.time() + timeout
        while time.time() < end:
            if predicate():
                return True
            time.sleep(0.1)
        return False

    def armed(self):
        hb = self.state.get('HEARTBEAT')
        return bool(hb and hb.base_mode & mavutil.mavlink.MAV_MODE_FLAG_SAFETY_ARMED)


def motor_test(v, joints):
    print('1. Motor test (disarmed, 12 % for 2 s each)', flush=True)
    for i, (letter, rotor, spin) in enumerate(MOTOR_TEST, start=1):
        v.command(mavutil.mavlink.MAV_CMD_DO_MOTOR_TEST, i, 0, 12, 2, 1, 0)
        time.sleep(1.2)
        vel = dict(joints.vel)
        fastest = max(vel, key=lambda k: abs(vel[k])) if vel else None
        ok = fastest == rotor and vel[fastest] * spin > 50
        spun = f'{fastest} at {vel[fastest]:+.0f} rad/s' if fastest else 'nothing'
        check(f'motor {letter} -> {rotor} {"CCW" if spin > 0 else "CW"}', ok, spun)
        time.sleep(1.5)


RATE_GAINS = [f'ATC_RAT_{axis}_{k}' for axis in ('RLL', 'PIT') for k in ('P', 'I', 'D')]


def param(v, name, value=None):
    """Read a parameter, or set it when value is given. Returns the FC's value."""
    if value is None:
        v.m.mav.param_request_read_send(v.m.target_system, v.m.target_component, name.encode(), -1)
    else:
        v.m.mav.param_set_send(v.m.target_system, v.m.target_component, name.encode(), float(value),
                               mavutil.mavlink.MAV_PARAM_TYPE_REAL32)
    end = time.time() + 3
    while time.time() < end:
        p = v.state.get('PARAM_VALUE')
        if p and p.param_id == name and (value is None or abs(p.param_value - value) < 1e-6):
            return p.param_value
        time.sleep(0.05)
    raise RuntimeError(f'no reply for parameter {name}')


def flight(v):
    print('2. AltHold flight via RC override', flush=True)
    v.rc = [1500, 1500, 1000, 1500, 0, 0, 0, 0]
    v.m.set_mode('ALT_HOLD')
    if not v.wait(lambda: v.state.get('HEARTBEAT') and mavutil.mode_string_v10(v.state['HEARTBEAT']) == 'ALT_HOLD', 15):
        check('switch to AltHold', False)
        return
    for _ in range(30):
        v.command(mavutil.mavlink.MAV_CMD_COMPONENT_ARM_DISARM, 1)
        if v.wait(v.armed, 2):
            break
    check('arm', v.armed())
    if not v.armed():
        return
    def height():
        g = v.get('GLOBAL_POSITION_INT')
        return g.relative_alt / 1000 if g else 0.0

    v.rc[2] = 1750                       # climb
    climbed = v.wait(lambda: height() > 3.0, 20)
    v.rc[2] = 1500                       # mid stick: AltHold holds altitude
    time.sleep(4)
    samples, alts, rates = [], [], []
    end = time.time() + 6
    while time.time() < end:
        s, a = v.get('SERVO_OUTPUT_RAW'), v.get('ATTITUDE')
        samples.append(sum((getattr(s, f'servo{k}_raw') - 1000) / 1000 for k in range(1, 5)) / 4)
        alts.append(height())
        rates.append(math.degrees(max(abs(a.rollspeed), abs(a.pitchspeed))))
        time.sleep(0.1)
    wobble = math.sqrt(sum(r * r for r in rates) / len(rates))
    check('roll/pitch steady in hover', wobble < 10, f'RMS of the larger of roll/pitch rate {wobble:.1f} deg/s')
    hover = sum(samples) / len(samples)
    check('climb above 3 m', climbed, f'height {height():.2f} m')
    held = max(alts) - min(alts) < 0.5
    check('hold altitude for 6 s', held, f'height {min(alts):.2f}-{max(alts):.2f} m')
    if held and wobble < 10:
        check('hover throttle near real drone', abs(hover - EXPECTED_HOVER) < 0.06,
              f'mean motor output {hover:.3f} (real MOT_THST_HOVER 0.35)')
    else:
        check('hover throttle near real drone', False, 'not measured: the drone was not in a steady hover')

    print('3. Yaw right for 2 s', flush=True)
    h0 = v.get('VFR_HUD').heading
    v.rc[3] = 1700
    time.sleep(2)
    v.rc[3] = 1500
    time.sleep(1)
    d = (v.get('VFR_HUD').heading - h0 + 540) % 360 - 180
    check('yaw right increases heading', d > 20, f'heading change {d:+.0f} deg')

    print('4. Land', flush=True)
    v.rc[2] = 1300                       # descend
    v.wait(lambda: height() < 0.3, 40)
    time.sleep(2)
    v.rc[2] = 1000                       # stick fully down so ArduPilot auto-disarms
    check('land and auto-disarm', v.wait(lambda: not v.armed(), 30), f'height {height():.2f} m')


def main():
    parser = argparse.ArgumentParser(description=__doc__, formatter_class=argparse.RawDescriptionHelpFormatter)
    parser.add_argument('--url', default='tcp:127.0.0.1:5762')
    parser.add_argument('--motors', action='store_true', help='only run the motor test')
    parser.add_argument('--rate-gain-scale', type=float, default=1.0,
                        help='multiply ATC_RAT_RLL/PIT P, I, D for this run (restored afterwards)')
    args = parser.parse_args()
    v = Vehicle(args.url)
    print(f'Connected to system {v.m.target_system}', flush=True)
    joints = Joints()
    time.sleep(2)
    motor_test(v, joints)
    if not args.motors:
        original = {}
        if args.rate_gain_scale != 1.0:
            original = {n: param(v, n) for n in RATE_GAINS}
            for n, val in original.items():
                param(v, n, val * args.rate_gain_scale)
            print(f'   roll/pitch rate gains x{args.rate_gain_scale} for this run', flush=True)
        try:
            flight(v)
        finally:
            for n, val in original.items():
                param(v, n, val)
    passed = sum(results)
    print(f'\n{passed}/{len(results)} checks passed', flush=True)
    sys.exit(0 if results and all(results) else 1)


if __name__ == '__main__':
    main()
