JayChintala/Multirotor-Operated-Lab-Experiments-MOLE/(commit log)

2026-10-04 Add Raspberry Pi companion computer setup
    - companion/setup.sh: idempotent setup for a fresh Pi (packages, UART,
    venv, mavlink-router build + service)
    - companion/check_link.py: read-only MAVLink link check via mavlink-router
    - companion/mavlink-router/main.conf: UART /dev/serial0 @ 921600 -> TCP 5760
    - companion/README.md: Pi setup, service control, GCS connection
    - Link to companion/ from the top-level README
2026-10-04 Add bench motor test and document FC settings
    - companion/motor_test.py: one-motor-at-a-time MAV_CMD_DO_MOTOR_TEST with
    YES prompt, 15 % / 5 s caps, armed check and link verification; never arms
    - companion/check_link.py: send a heartbeat before the first request so the
    FC answers it (firmware/GPS/battery were showing n/a)
    - companion/README.md: FC parameter table (MOT_PWM_TYPE=6 / DShot600 needed
    for the Lucid 4-in-1 ESC), bench notes, motor test usage
    - companion/setup.sh: mention motor_test.py in the final output
2026-10-05 updaded comments for Prototype 1 code review
2026-10-05 Water Detection Circuit
2026-10-07 Push the code for valve logic
2026-10-25 Add telemetry bridge, gamepad inputs and motor panel to control center
2026-10-26 Add mole-wifi: manual switch between home Wi-Fi and a MOLE hotspot
2026-10-27 Record motor direction and DShot ESC parameters
2026-11-09 Port EMSD ROS package to ROS 2 Jazzy / Gazebo Harmonic
    Extract EMSD_reproducible_source.zip into ROS/EMSD and make it build on
    Ubuntu 24.04 (Jazzy + Harmonic) while keeping Humble + Fortress working:
    - simulation/gz_compat.hh selects gz-sim8 or ignition-gazebo6 headers and
    namespaces; MotorPhysics.cc, headless.cc and the C++ test use it
    - CMakeLists.txt prefers gz-sim8/gz-physics7/gz-plugin2 and falls back to
    Fortress (-DEMSD_GZ=fortress to force)
    - control/gazebo_backend.py picks gz sim / ign gazebo, transport env vars,
    message types, GUI config and system plugin names at run time
    - package.xml uses distro-conditional dependencies
    - SetupRos.md documents both platforms
    Verified on J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
2026-11-09 Add ArduPilot SITL + Gazebo Harmonic simulation of the MOLE quad
    sim/ros2_ws/src/mole_gazebo: ROS 2 Jazzy package that flies the MOLE quad
    with ArduCopter 4.7.2 SITL (same build as the FC) in Gazebo Harmonic.
    - models/mole_quad generated by scripts/gen_model.py from config/vehicle.json:
    2.252 kg incl. battery and props, inertia from CAD + battery, motor layout
    in body axes, thrust/torque from motor_data.xlsx, torque cap at the
    measured 2.0 kgf / 34.5 A, real FC output mapping and spin directions
    - config/mole_quad.parm: 337 flight parameters extracted from flight log
    00016 by scripts/extract_params.py, plus sim-only overrides and gps/nogps
    variants
    - launch/sitl.launch.py: Gazebo,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
2026-11-11 Add a kill switch: force-disarm on laptop KILL or link loss
    kill_switch.py runs on the Pi as the kill-switch service. It force-disarms
    the FC (MAV_CMD_COMPONENT_ARM_DISARM, 21196) when the control center sends
    KILL, or when the FC is armed and the laptop heartbeat has stopped for 1 s.
    The laptop backend sends that heartbeat at 10 Hz while a control center page
    is open, and the control center gets a KILL bar (also Space) showing whether
    the watchdog link is live.
